Electro707/PCB-4-In-A-Row/KiCAD Files/LED PCB/PCB.kicad_pcb

## KiCad design KiCAD Files/LED PCB/PCB.kicad_pcb (2022-03-26)

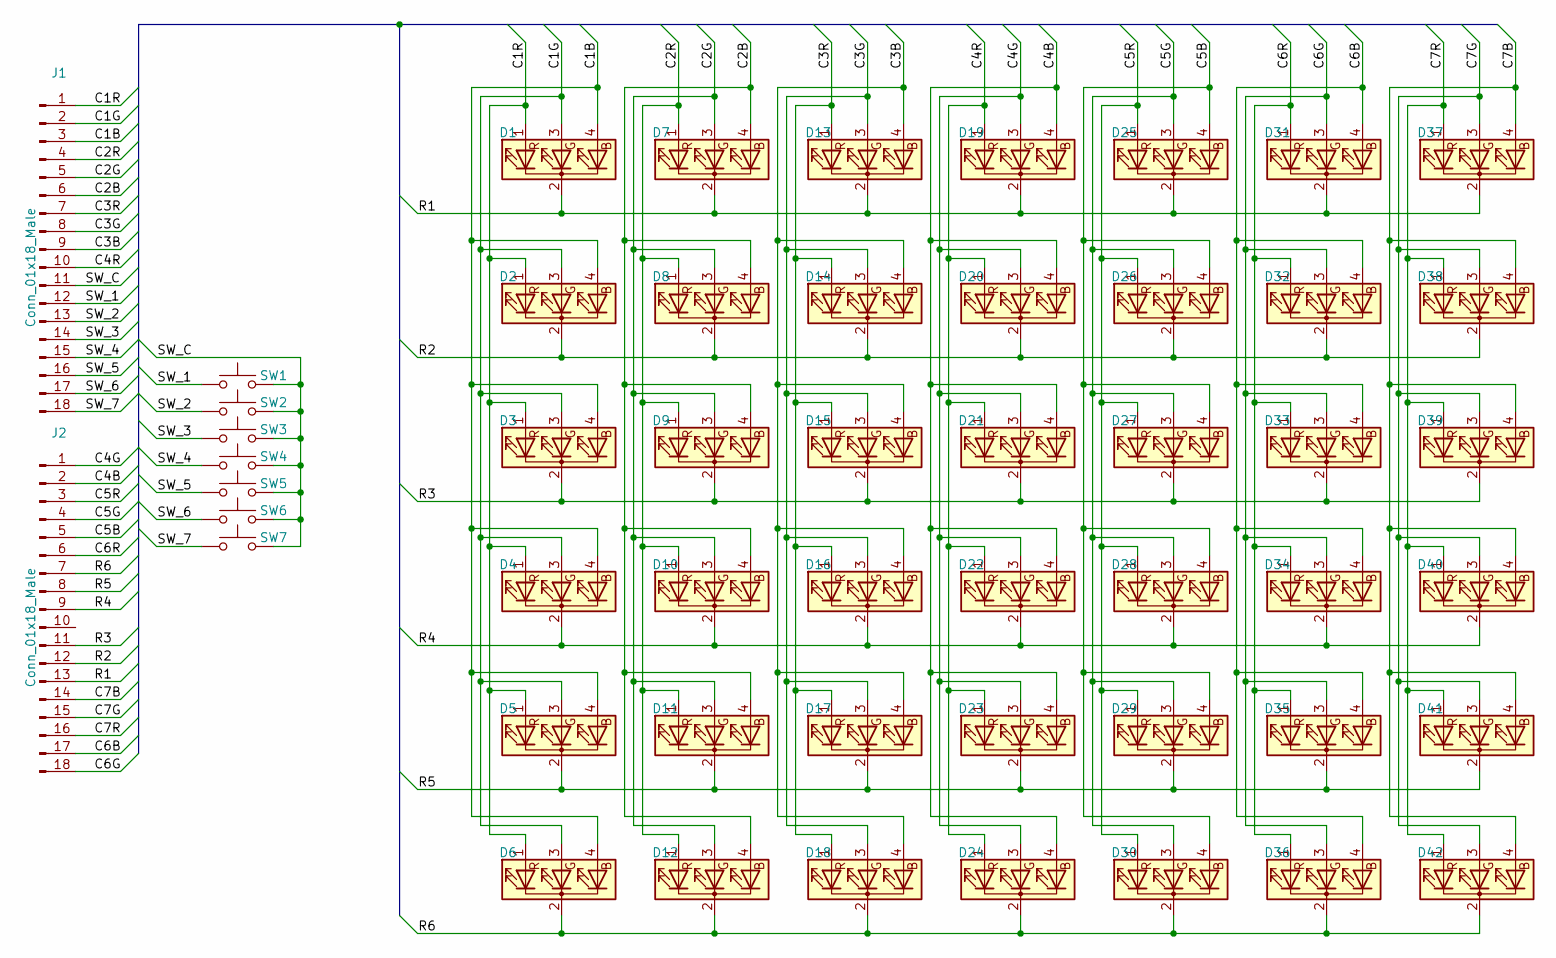
[picture p3: schematic PCB.kicad_sch, 4-In-A-Row Soldering Kit LED Board]

Parts:
D1, D2, D3, D4, D5, D6, D7, D8, D9, D10, D11, D12, D13, D14, D15, D16, D17, D18, D19, D20, D21, D22, D23, D24, D25, D26, D27, D28, D29, D30, D31, D32, D33, D34, D35, D36, D37, D38, D39, D40, D41, D42: LED_RCGB; LED_D5.0mm-4_RGB_Staggered_Pins
J1, J2: Conn_01x18_Male; PinHeader_1x18_P2.54mm_Vertical
SW1, SW2, SW3, SW4, SW5, SW6, SW7: SW_Push; SW_PUSH_6mm_H8mm

Connections:
/C1B: D1.4 (BA), D2.4 (BA), D3.4 (BA), D4.4 (BA), D5.4 (BA), D6.4 (BA), J1.3
/C1G: D1.3 (GA), D2.3 (GA), D3.3 (GA), D4.3 (GA), D5.3 (GA), D6.3 (GA), J1.2
/C1R: D1.1 (RA), D2.1 (RA), D3.1 (RA), D4.1 (RA), D5.1 (RA), D6.1 (RA), J1.1
/C2B: D7.4 (BA), D8.4 (BA), D9.4 (BA), D10.4 (BA), D11.4 (BA), D12.4 (BA), J1.6
/C2G: D7.3 (GA), D8.3 (GA), D9.3 (GA), D10.3 (GA), D11.3 (GA), D12.3 (GA), J1.5
/C2R: D7.1 (RA), D8.1 (RA), D9.1 (RA), D10.1 (RA), D11.1 (RA), D12.1 (RA), J1.4
/C3B: D13.4 (BA), D14.4 (BA), D15.4 (BA), D16.4 (BA), D17.4 (BA), D18.4 (BA), J1.9
/C3G: D13.3 (GA), D14.3 (GA), D15.3 (GA), D16.3 (GA), D17.3 (GA), D18.3 (GA), J1.8
/C3R: D13.1 (RA), D14.1 (RA), D15.1 (RA), D16.1 (RA), D17.1 (RA), D18.1 (RA), J1.7
/C4B: D19.4 (BA), D20.4 (BA), D21.4 (BA), D22.4 (BA), D23.4 (BA), D24.4 (BA), J2.2
/C4G: D19.3 (GA), D20.3 (GA), D21.3 (GA), D22.3 (GA), D23.3 (GA), D24.3 (GA), J2.1
/C4R: D19.1 (RA), D20.1 (RA), D21.1 (RA), D22.1 (RA), D23.1 (RA), D24.1 (RA), J1.10
/C5B: D25.4 (BA), D26.4 (BA), D27.4 (BA), D28.4 (BA), D29.4 (BA), D30.4 (BA), J2.5
/C5G: D25.3 (GA), D26.3 (GA), D27.3 (GA), D28.3 (GA), D29.3 (GA), D30.3 (GA), J2.4
/C5R: D25.1 (RA), D26.1 (RA), D27.1 (RA), D28.1 (RA), D29.1 (RA), D30.1 (RA), J2.3
/C6B: D31.4 (BA), D32.4 (BA), D33.4 (BA), D34.4 (BA), D35.4 (BA), D36.4 (BA), J2.17
/C6G: D31.3 (GA), D32.3 (GA), D33.3 (GA), D34.3 (GA), D35.3 (GA), D36.3 (GA), J2.18
/C6R: D31.1 (RA), D32.1 (RA), D33.1 (RA), D34.1 (RA), D35.1 (RA), D36.1 (RA), J2.6
/C7B: D37.4 (BA), D38.4 (BA), D39.4 (BA), D40.4 (BA), D41.4 (BA), D42.4 (BA), J2.14
/C7G: D37.3 (GA), D38.3 (GA), D39.3 (GA), D40.3 (GA), D41.3 (GA), D42.3 (GA), J2.15
/C7R: D37.1 (RA), D38.1 (RA), D39.1 (RA), D40.1 (RA), D41.1 (RA), D42.1 (RA), J2.16
/R1: D1.2 (K), D7.2 (K), D13.2 (K), D19.2 (K), D25.2 (K), D31.2 (K), D37.2 (K), J2.13
/R2: D2.2 (K), D8.2 (K), D14.2 (K), D20.2 (K), D26.2 (K), D32.2 (K), D38.2 (K), J2.12
/R3: D3.2 (K), D9.2 (K), D15.2 (K), D21.2 (K), D27.2 (K), D33.2 (K), D39.2 (K), J2.11
/R4: D4.2 (K), D10.2 (K), D16.2 (K), D22.2 (K), D28.2 (K), D34.2 (K), D40.2 (K), J2.9
/R5: D5.2 (K), D11.2 (K), D17.2 (K), D23.2 (K), D29.2 (K), D35.2 (K), D41.2 (K), J2.8
/R6: D6.2 (K), D12.2 (K), D18.2 (K), D24.2 (K), D30.2 (K), D36.2 (K), D42.2 (K), J2.7
/SW_1: J1.12, SW1.1
/SW_2: J1.13, SW2.1
/SW_3: J1.14, SW3.1
/SW_4: J1.15, SW4.1
/SW_5: J1.16, SW5.1
/SW_6: J1.17, SW6.1
/SW_7: J1.18, SW7.1
/SW_C: J1.11, SW1.2, SW2.2, SW3.2, SW4.2, SW5.2, SW6.2, SW7.2

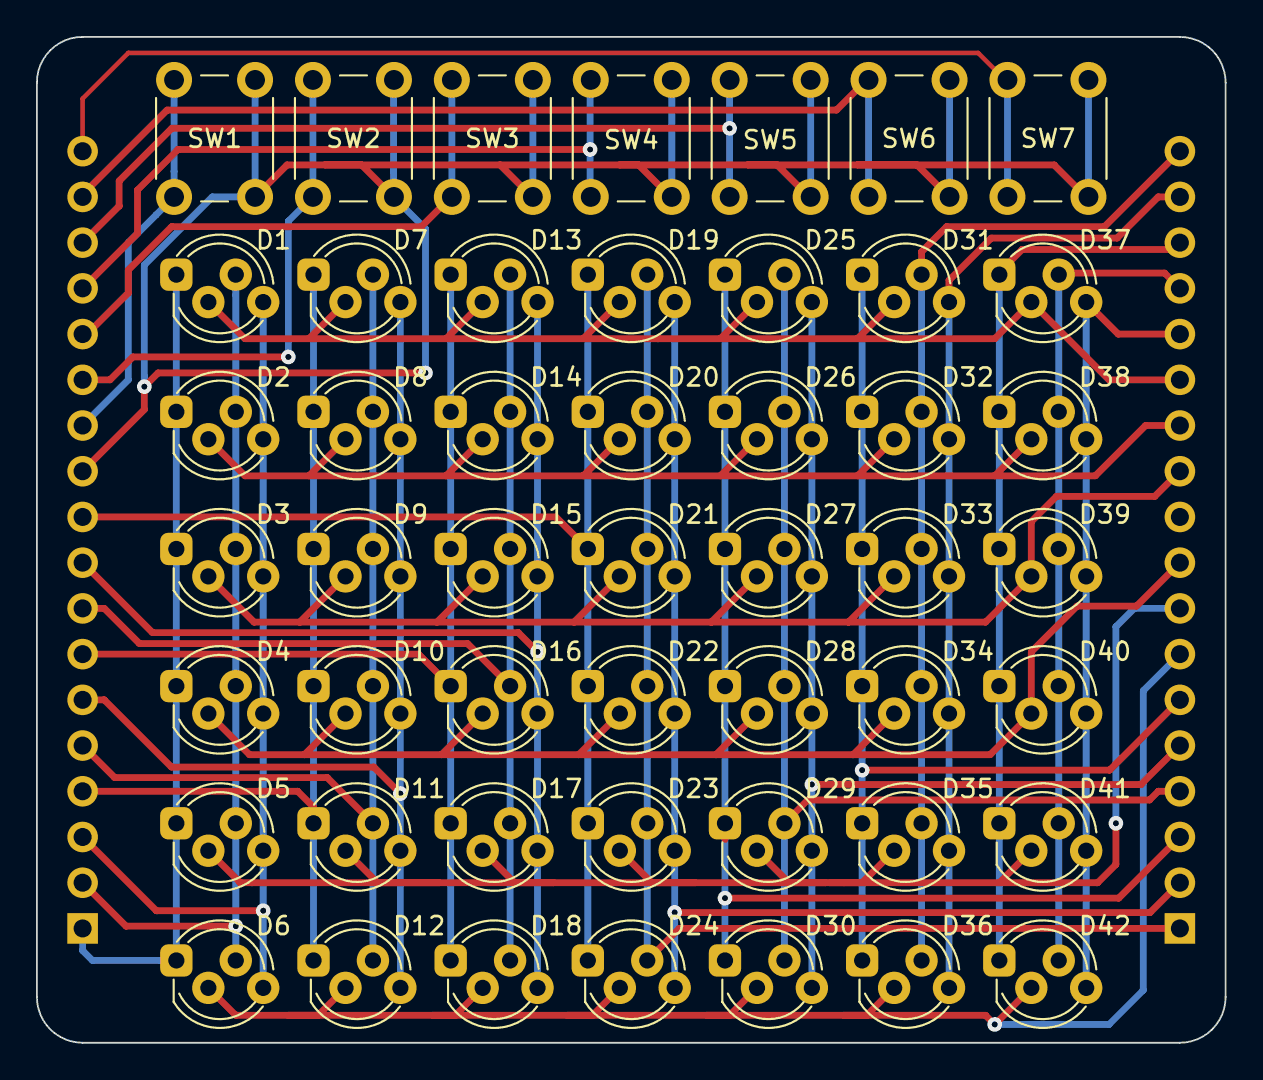
[picture p4: board KiCAD Files/LED PCB/PCB.kicad_pcb from above]

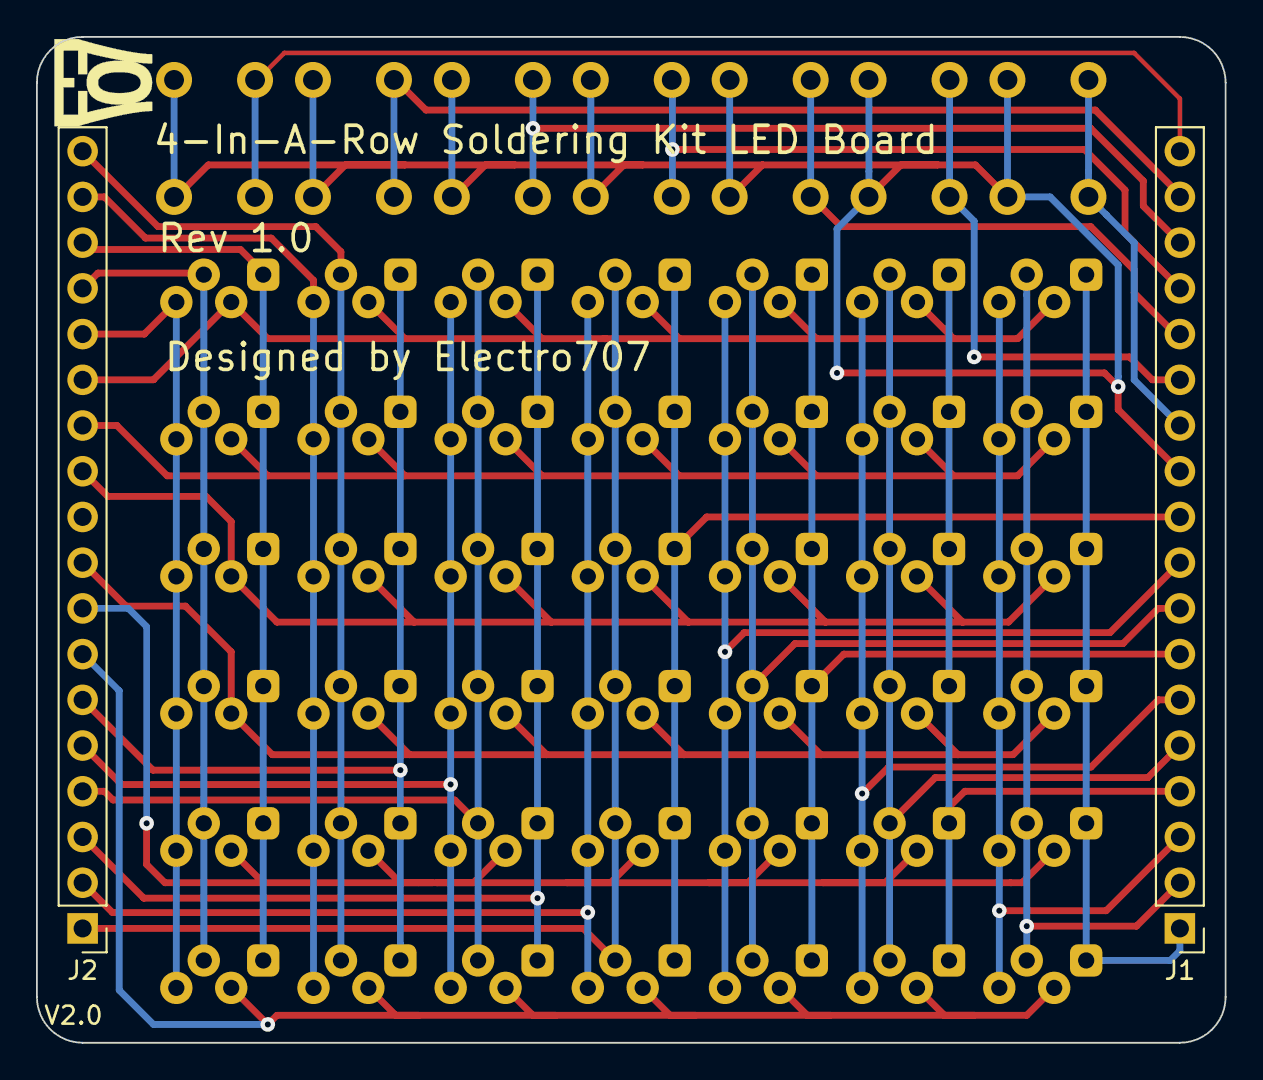
[picture p5: board KiCAD Files/LED PCB/PCB.kicad_pcb from below]

Board: 2 copper layers, 66.0 x 55.9 mm, 51 parts (2 on the bottom side), 35 nets.
